DF4IAH/Smart-LCD/Docs/11_CPU_&_Temp/ATmega328P/ISP_Headers.png

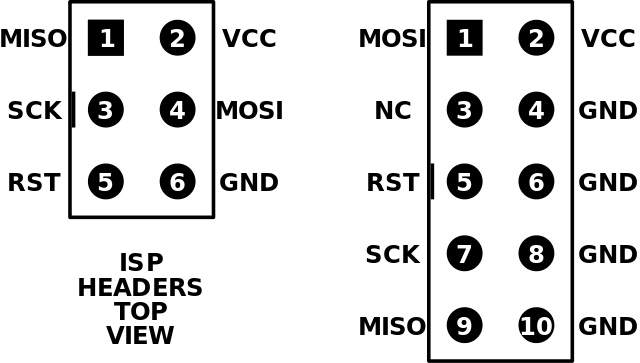
Docs/11_CPU_&_Temp/ATmega328P/ISP_Headers.png
