DF4IAH/Smart-LCD/Docs/61_Designing/Smart-LCD_1V1_BOM_6_calculations.xlsx

Stückliste exportiert aus Smart-LCD_1V1.sch am 30.05.17 14:22 |  |  |  |  |  | Nachbearbeitet von DF4IAH, 2017-05-30 | Preisgestaltung
Qty | Value | Device | Package | Parts | Description | Bemerkungen | Einzelpreis | Preis
1 | Smart-LCD V1.0 | Leiterplatte | 100 mm x 68 mm | PCB001 | PCB, Designed by DF4IAH | Smart-LCD V1.0 Leiterplatte | €6.90 | €6.90
1 | 27R | R-EU_R0805 | R0805 | R131 | RESISTOR, European symbol | Fotodioden-Eingang Schutzwiderstand. | €0.03 | €0.03
2 | 330R | R-EU_R0805 | R0805 | R151, R152 | RESISTOR, European symbol |  | €0.03 | €0.06
2 | 1kR | R-EU_R0805 | R0805 | R391, R392 | RESISTOR, European symbol | I2C-Bus open collector Sammelwiderstände. | €0.03 | €0.06
1 | 3.3kR | R-EU_R0805 | R0805 | R111 | RESISTOR, European symbol |  | €0.03 | €0.03
1 | 4.7kR | R-EU_R0805 | R0805 | R121 | RESISTOR, European symbol |  | €0.03 | €0.03
1 | 12kR | R-EU_R0805 | R0805 | R101 | RESISTOR, European symbol |  | €0.03 | €0.03
2 | 22kR | R-EU_R0805 | R0805 | R451, R454 | RESISTOR, European symbol |  | €0.03 | €0.06
1 | 100kR | R-EU_R0805 | R0805 | R221 | RESISTOR, European symbol |  | €0.03 | €0.03
1 | 650kR | R-EU_R0805 | R0805 | R222 | RESISTOR, European symbol |  | €0.03 | €0.03
1 | 1MR | R-EU_R0805 | R0805 | R132 | RESISTOR, European symbol | Fotodioden Arbeitspunkt. Noch experimental. | €0.05 | €0.05
1 | 10MR | R-EU_R0805 | R0805 | R211 | RESISTOR, European symbol | Ableitwiderstand für LCD-Modul bei Abschaltung. | €0.10 | €0.10
2 | 100pF | C-EUC0805 | C0805 | C103, C131 | CAPACITOR, European symbol |  | €0.20 | €0.40
1 | 470pF | C-EUC0805 | C0805 | C452 | CAPACITOR, European symbol |  | €0.20 | €0.20
6 | 100nF | C-EUC0805 | C0805 | C102, C111, C221, C301, C302, C402 | CAPACITOR, European symbol |  | €0.20 | €1.20
1 | 470nF | C-EUC0805 | C0805 | C455 | CAPACITOR, European symbol |  | €0.20 | €0.20
2 | 1uF | C-EUC0805 | C0805 | C211, C431 | CAPACITOR, European symbol |  | €0.20 | €0.40
2 | 4.7uF | C-EUC0805 | C0805 | C201, C202 | CAPACITOR, European symbol |  | €0.80 | €1.60
2 | 22uF | C-EUC0805 | C0805 | C101, C401 | CAPACITOR, European symbol |  | €1.25 | €2.50
2 | 47uF | C-EUC0805 | C0805 | C411, C412 | CAPACITOR, European symbol |  | €1.50 | €3.00
1 | BZX84-C2V4 | BAS70-04 | SOT23 | D131 | Silicon Schottky Diodes | Schutzdioden für Fotodioden-Eingang. Noch experimental. | €0.10 | €0.10
1 | MMBT2222AL | MMBT2222AL | SOT23 | Q121 | MMBT2222L, MMBT2222AL, SMMBT2222AL | NPN-Transistor für Backlight ein/aus (PWM). | €0.10 | €0.10
1 | MEGA8-P | MEGA8-P | DIL28-3 | U101 | MICROCONTROLLER | µC ATmega 328P. Kann zusätzlich gesockelt werden. | €2.20 | €2.20
1 | DIL28-3 | SOCKET | DIL28-3 | U101a | DIL socket | Präzissionsfassung, 28-polig, schmal (0,3 Zoll) | €1.80 | €1.80
1 | TS4871ID | TS4871ID | SO08 | U401 | STMICROELECTRONICS TS4871ID | Audioverstärker für einen Kanal. | €1.90 | €1.90
1 | LCD_23WAY__UC1608 | LCD_23WAY__UC1608 | 23X01_1MM27__UC1608 | X201 | Gfx-LCD UC1608 socket | 240x128 Pixel Gfx-Display wird direkt eingelötet. | €39.90 | €39.90
1 | Audio-Stiftleiste | HEADER-2X2 | 2X02 | X411 | Header 2X2 2.54mm | Anschluss für Lautsprecher mit Impedanz von >= 8 Ohm. | €0.60 | €0.60
1 | I2C-Stiftleiste | HEADER-2X3 | 2X03 | X301 | Header 2X3 2.54mm | Anschluss für I2C Stecker. | €0.80 | €0.80
1 | LDR-Stiftleiste | HEADER-1X2 | 1X02 | X131 | Header 1X2 2.54mm | Fotodioden-Anschluss. Noch experimental. | €0.60 | €0.60
1 | LEDs-Stiftleiste | HEADER-2X2 | 2X02 | X151 | Header 2X2 2.54mm | Anschluss für Duo-LEDs. | €0.60 | €0.60
1 | Switches-Stiftleiste | HEADER-2X2 | 2X02 | X141 | Header 2X2 2.54mm | Anschluss für Dreh-/Druckknopf mit I/Q Ausgang. | €0.60 | €0.60
 |  |  |  |  |  | SUMME |  | €66.11
