DF4IAH/Smart-LCD/CAD/Eagle/Smart-LCD_1V1.brd

## EAGLE design CAD/Eagle/Smart-LCD_1V1.brd (2017-06-25)

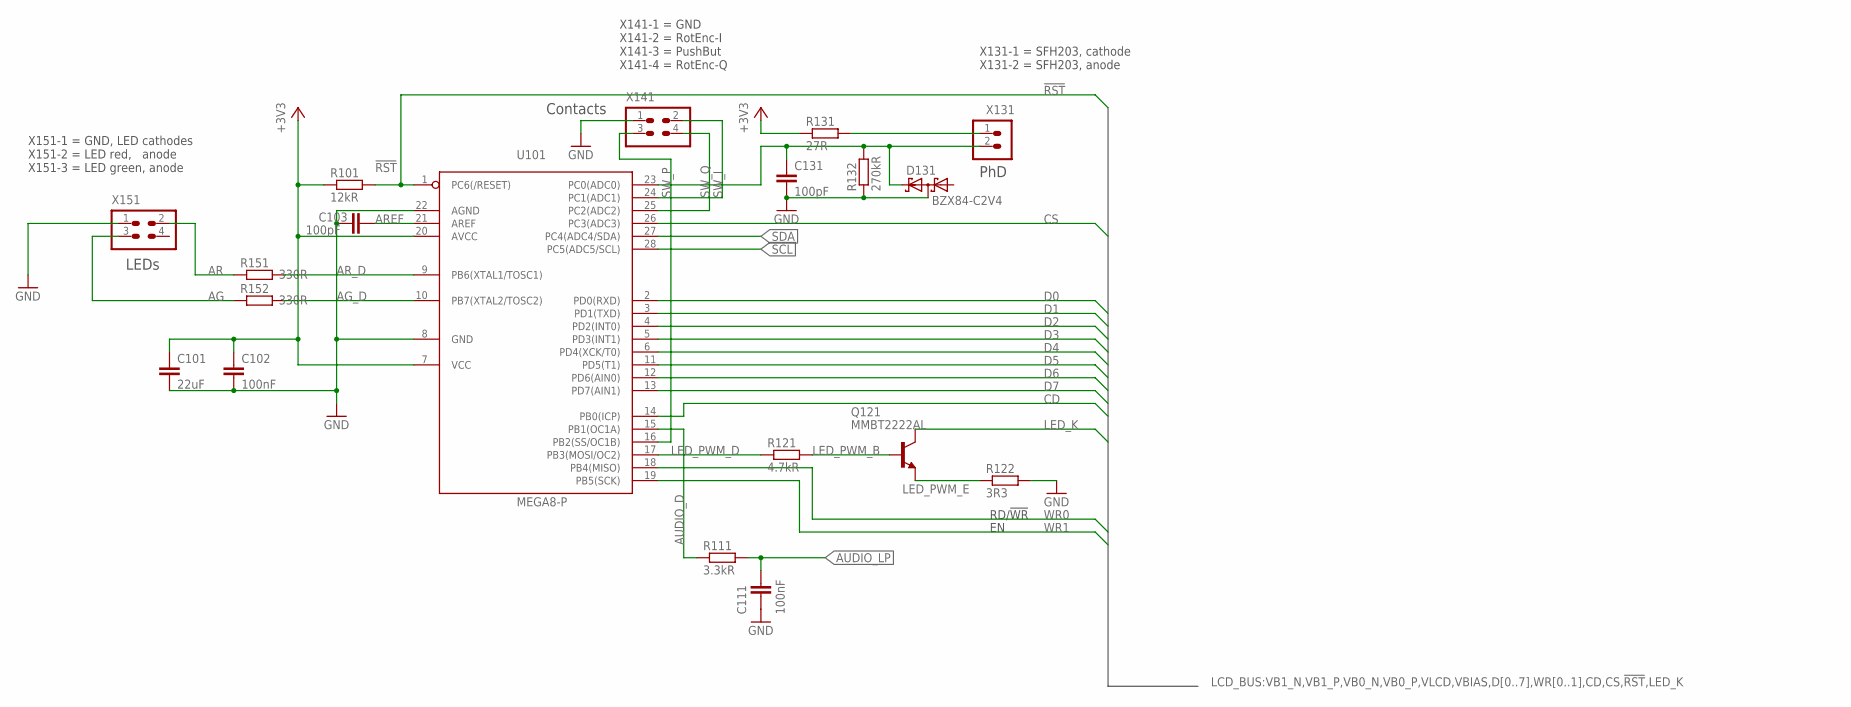
[picture p3: schematic Smart-LCD_1V1.sch, sheet 1, MPU]

Parts:
C101: 22uF; C0805
C102, C111: 100nF; C0805
C103, C131: 100pF; C0805
D131: BZX84-C2V4; SOT23
Q121: MMBT2222AL; SOT23
R101: 12kR; R0805
R111: 3.3kR; R0805
R121: 4.7kR; R0805
R122: 3R3; R0805
R131: 27R; R0805
R132: 270kR; R0805
R151, R152: 330R; R0805
U101: MEGA8-P; DIL28-3
X131: LDR; 1X02
X141: Switches; 2X02
X151: LEDs; 2X02

Connections:
!RST: R101.2, U101.1 (PC6(/RESET)); also elsewhere on the board
+3V3: C101.1, C102.1, R101.1, R131.1, U101.7 (VCC), U101.20 (AVCC); also elsewhere on the board
AG: R152.1, X151.3
AG_D: R152.2, U101.10 (PB7(XTAL2/TOSC2))
AR: R151.1, X151.2
AREF: C103.2, U101.21 (AREF)
AR_D: R151.2, U101.9 (PB6(XTAL1/TOSC1))
AUDIO_D: R111.1, U101.15 (PB1(OC1A))
AUDIO_LP: C111.1, R111.2; also elsewhere on the board
CD: U101.14 (PB0(ICP)); also elsewhere on the board
CS: U101.26 (PC3(ADC3)); also elsewhere on the board
D0: U101.2 (PD0(RXD)); also elsewhere on the board
D1: U101.3 (PD1(TXD)); also elsewhere on the board
D2: U101.4 (PD2(INT0)); also elsewhere on the board
D3: U101.5 (PD3(INT1)); also elsewhere on the board
D4: U101.6 (PD4(XCK/T0)); also elsewhere on the board
D5: U101.11 (PD5(T1)); also elsewhere on the board
D6: U101.12 (PD6(AIN0)); also elsewhere on the board
D7: U101.13 (PD7(AIN1)); also elsewhere on the board
GND: C101.2, C102.2, C103.1, C111.2, C131.2, D131.3 (C1A2), R122.2, R132.1, U101.8 (GND), U101.22 (AGND), X141.1, X151.1; also elsewhere on the board
LDR: C131.1, D131.2 (C2), R132.2, U101.23 (PC0(ADC0)), X131.2
LDR_P: R131.2, X131.1
LED_K: Q121.3 (C); also elsewhere on the board
LED_PWM_B: Q121.1 (B), R121.2
LED_PWM_D: R121.1, U101.17 (PB3(MOSI/OC2))
LED_PWM_E: Q121.2 (E), R122.1
SCL: U101.28 (PC5(ADC5/SCL)); also elsewhere on the board
SDA: U101.27 (PC4(ADC4/SDA)); also elsewhere on the board
SW_I: U101.24 (PC1(ADC1)), X141.2
SW_P: U101.16 (PB2(SS/OC1B)), X141.3
SW_Q: U101.25 (PC2(ADC2)), X141.4
WR0: U101.18 (PB4(MISO)); also elsewhere on the board
WR1: U101.19 (PB5(SCK)); also elsewhere on the board

Notes on the sheet:
PhD
Contacts
LEDs
RD/!WR
X131-1 = SFH203, cathode X131-2 = SFH203, anode
X151-1 = GND, LED cathodes X151-2 = LED red, anode X151-3 = LED green, anode
X141-1 = GND X141-2 = RotEnc-I X141-3 = PushBut X141-4 = RotEnc-Q

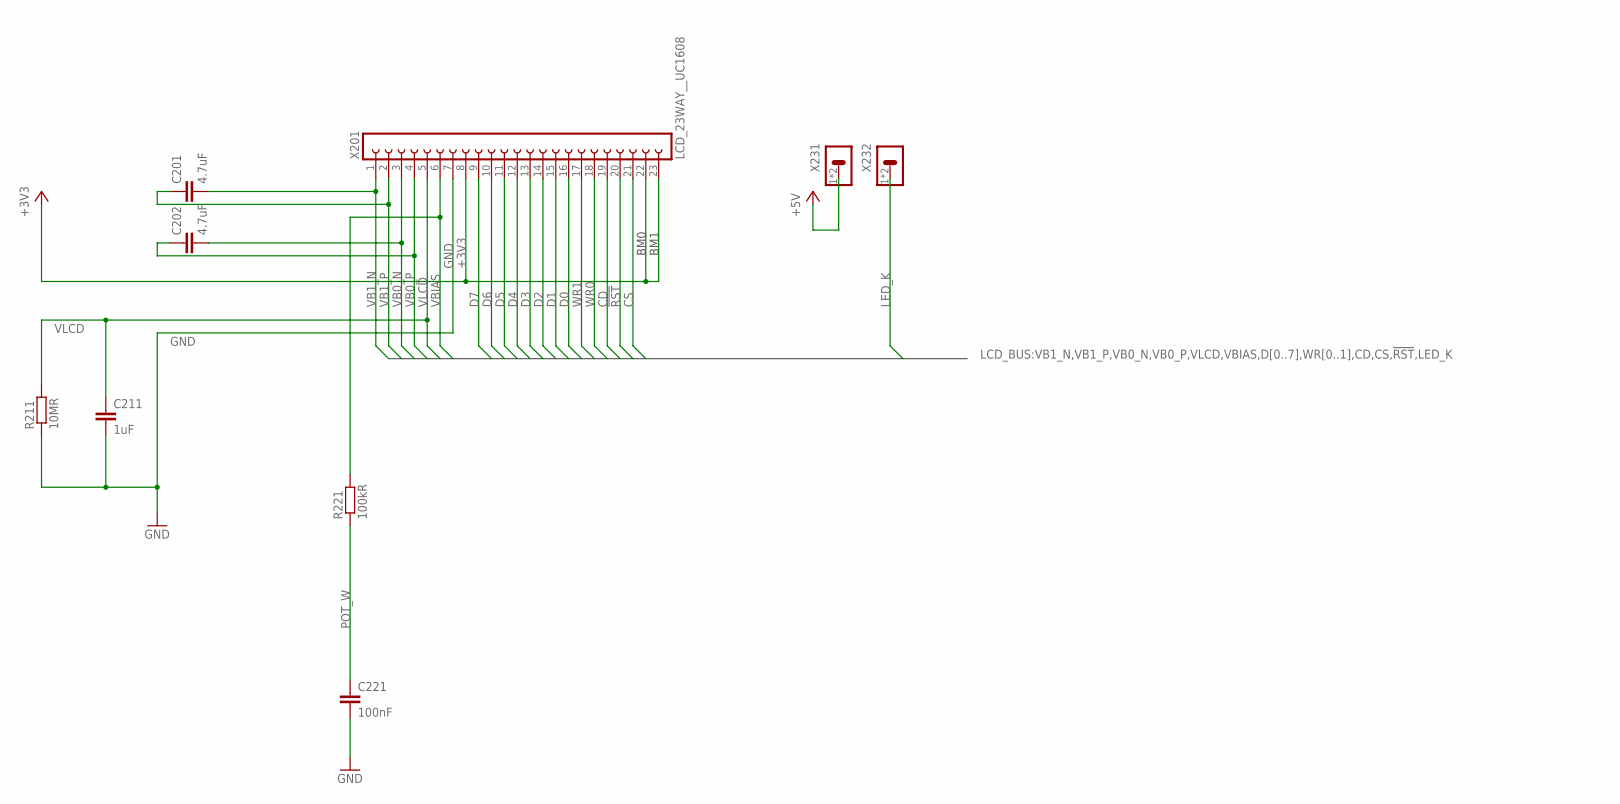
[picture p4: schematic Smart-LCD_1V1.sch, sheet 2, LCD panel]

Parts:
C201, C202: 4.7uF; C0805
C211: 1uF; C0805
C221: 100nF; C0805
R211: 10MR; R0805
R221: 100kR; R0805
X201: LCD_23WAY__UC1608; 23X01_1MM27__UC1608
X231: LED_A; P1-20X0.80
X232: LED_K; P1-20X0.80

Connections:
!RST: X201.20; also elsewhere on the board
+3V3: X201.8, X201.22, X201.23; also elsewhere on the board
+5V: X231.1, X231.2; also elsewhere on the board
CD: X201.19; also elsewhere on the board
CS: X201.21; also elsewhere on the board
D0: X201.16; also elsewhere on the board
D1: X201.15; also elsewhere on the board
D2: X201.14; also elsewhere on the board
D3: X201.13; also elsewhere on the board
D4: X201.12; also elsewhere on the board
D5: X201.11; also elsewhere on the board
D6: X201.10; also elsewhere on the board
D7: X201.9; also elsewhere on the board
GND: C211.2, C221.2, R211.1, X201.7; also elsewhere on the board
LED_K: X232.1, X232.2; also elsewhere on the board
POT_W: C221.1, R221.1
VB0_N: C202.2, X201.3
VB0_P: C202.1, X201.4
VB1_N: C201.2, X201.1
VB1_P: C201.1, X201.2
VBIAS: R221.2, X201.6
VLCD: C211.1, R211.2, X201.5
WR0: X201.18; also elsewhere on the board
WR1: X201.17; also elsewhere on the board

Notes on the sheet:
BM1
BM0

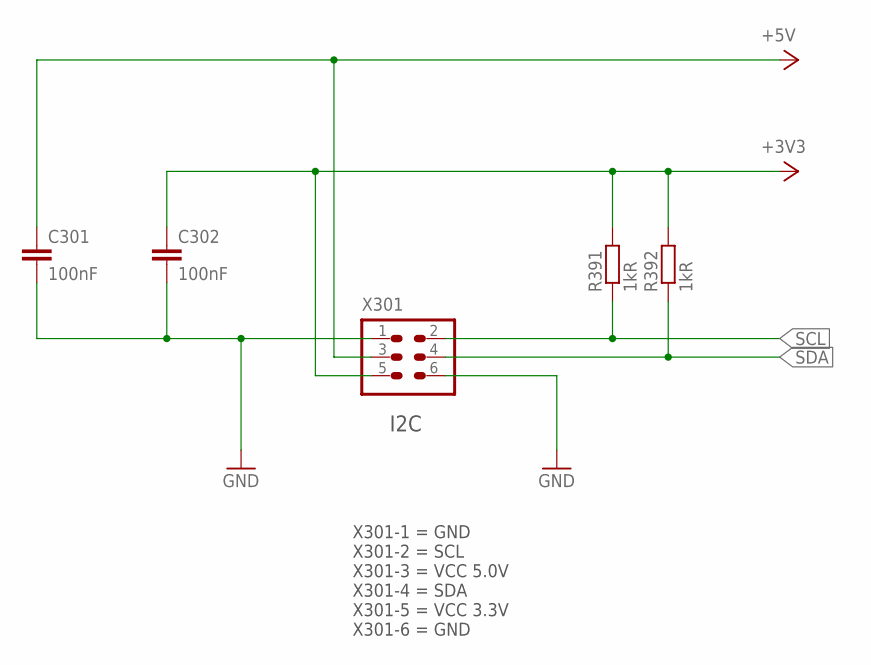
[picture p5: schematic Smart-LCD_1V1.sch, sheet 3, I2C connector]

Parts:
C301, C302: 100nF; C0805
R391, R392: 1kR; R0805
X301: I2C; 2X03

Connections:
+3V3: C302.1, R391.2, R392.2, X301.5; also elsewhere on the board
+5V: C301.1, X301.3; also elsewhere on the board
GND: C301.2, C302.2, X301.1, X301.6; also elsewhere on the board
SCL: R391.1, X301.2; also elsewhere on the board
SDA: R392.1, X301.4; also elsewhere on the board

Notes on the sheet:
I2C
X301-1 = GND X301-2 = SCL X301-3 = VCC 5.0V X301-4 = SDA X301-5 = VCC 3.3V X301-6 = GND

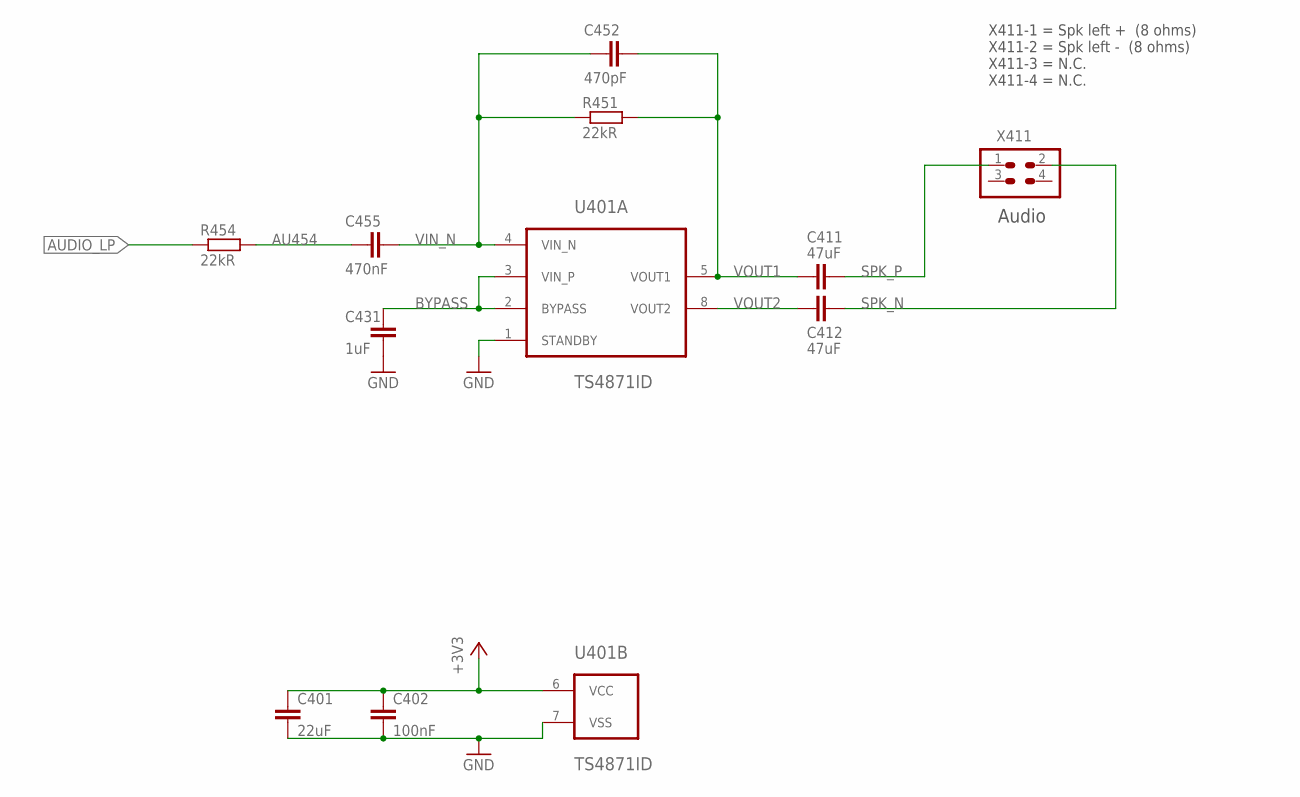
[picture p6: schematic Smart-LCD_1V1.sch, sheet 4, Audio]

Parts:
C401: 22uF; C0805
C402: 100nF; C0805
C411, C412: 47uF; C0805
C431: 1uF; C0805
C452: 470pF; C0805
C455: 470nF; C0805
R451, R454: 22kR; R0805
U401: TS4871ID; SO08
X411: Audio; 2X02

Connections:
+3V3: C401.1, C402.1, U401.6 (VCC); also elsewhere on the board
AU454: C455.1, R454.2
AUDIO_LP: R454.1; also elsewhere on the board
BYPASS: C431.1, U401.2 (BYPASS), U401.3 (VIN_P)
GND: C401.2, C402.2, C431.2, U401.1 (STANDBY), U401.7 (VSS); also elsewhere on the board
SPK_N: C412.2, X411.2
SPK_P: C411.2, X411.1
VIN_N: C452.1, C455.2, R451.1, U401.4 (VIN_N)
VOUT1: C411.1, C452.2, R451.2, U401.5 (VOUT1)
VOUT2: C412.1, U401.8 (VOUT2)

Notes on the sheet:
Audio
X411-1 = Spk left + (8 ohms) X411-2 = Spk left - (8 ohms) X411-3 = N.C. X411-4 = N.C.

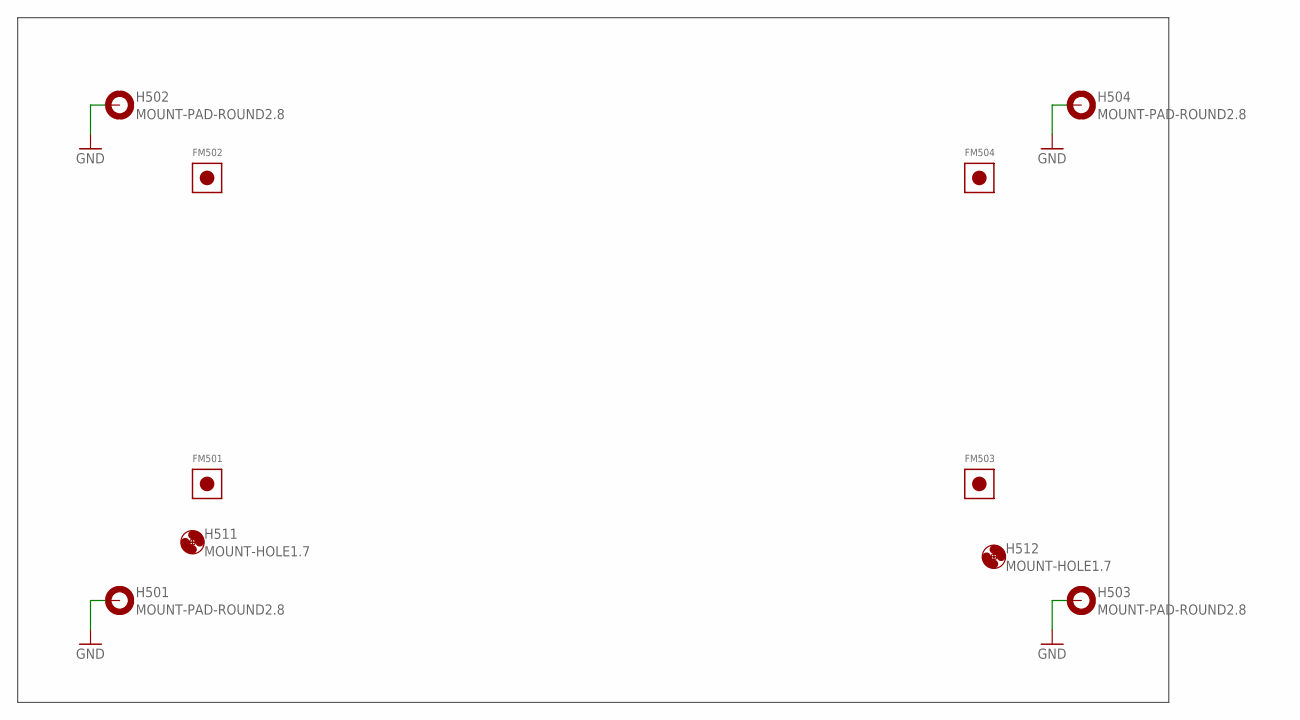
[picture p7: schematic Smart-LCD_1V1.sch, sheet 5, Holes]

Parts:
FM501, FM502, FM503, FM504: FIDUCIAL_MARK_1MM
H501, H502, H503, H504: MOUNT-PAD-ROUND2.8; 2,8-PAD
H511, H512: MOUNT-HOLE1.7; 1,7

Connections:
GND: H501.B2,8, H502.B2,8, H503.B2,8, H504.B2,8; also elsewhere on the board

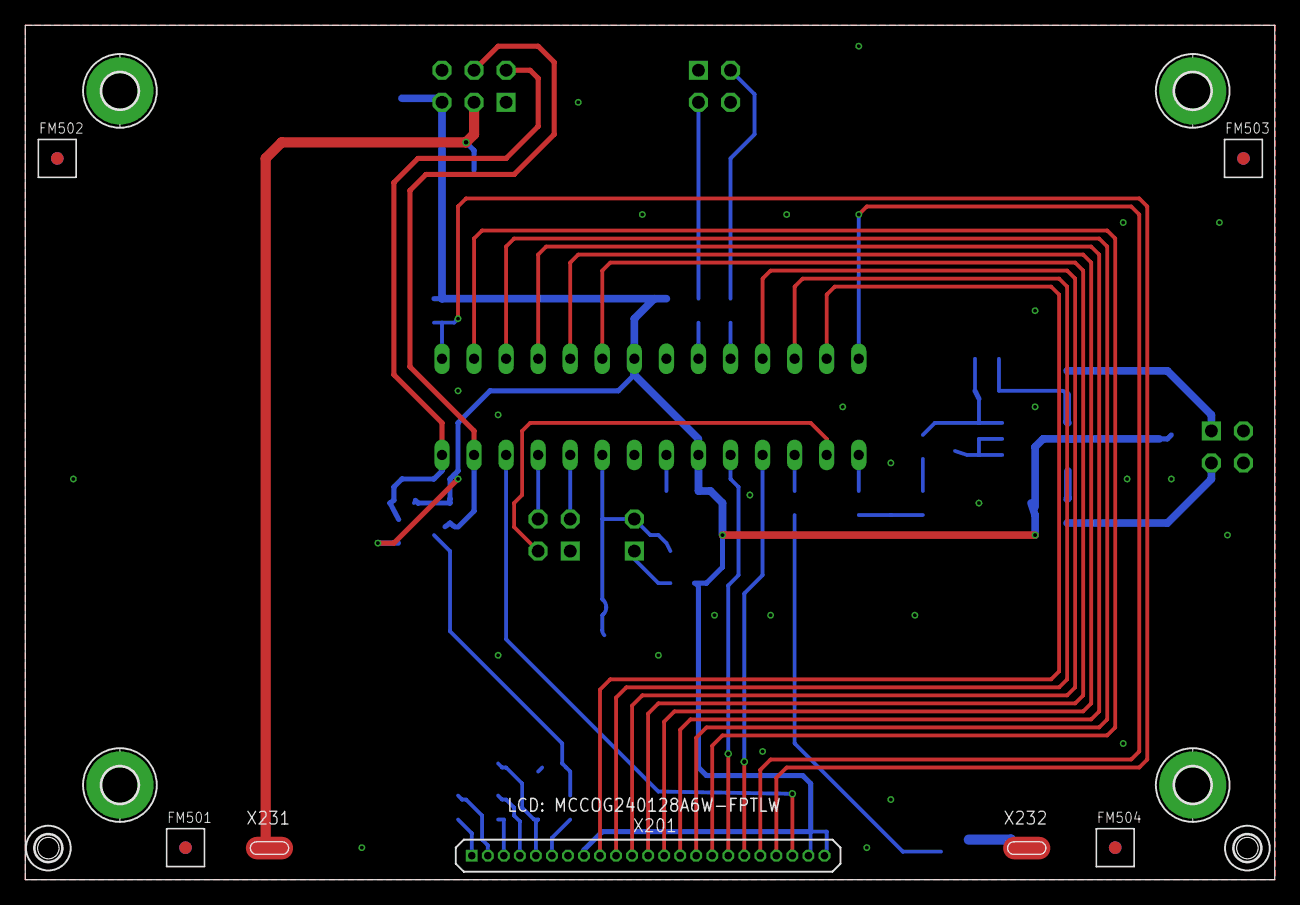
[picture p8: board Smart-LCD_1V1.brd from above]

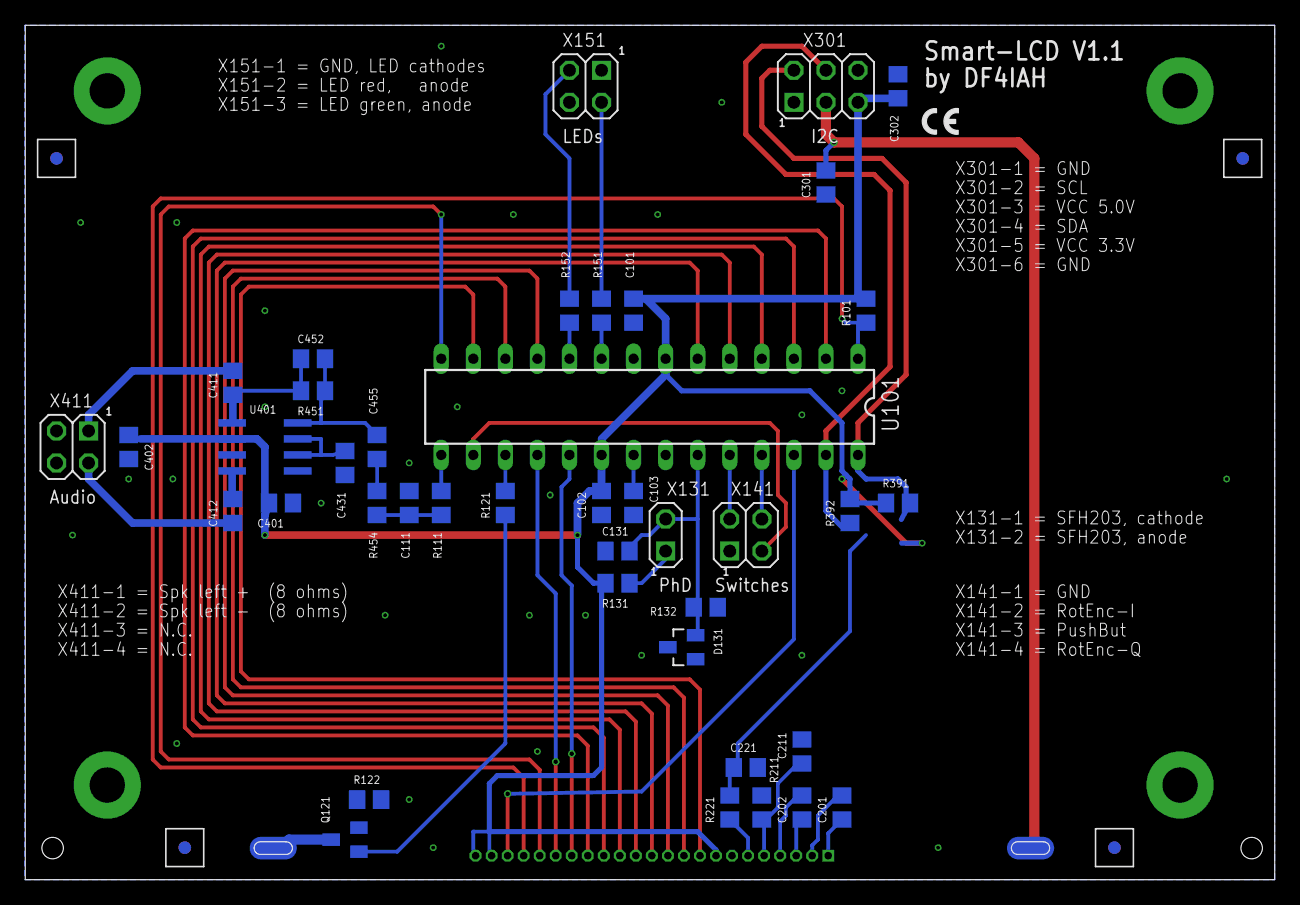
[picture p9: board Smart-LCD_1V1.brd from below]

Board: 2 copper layers, 99.0 x 67.7 mm, 54 parts (41 on the bottom side), 48 nets.
