DF4IAH/Smart-LCD/Smart-LCD_SW/Smart-LCD_SW/src/gfx_mono/gfx_mono_lcd_uc1608.c

/**
 * \file
 *
 * \brief Monochrome graphic library for the UC1608 LCD controller
 *
 * Copyright (c) 2011-2017 Atmel Corporation. All rights reserved.
 *
 * \asf_license_start
 *
 * \page License
 *
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
 * 3. The name of Atmel may not be used to endorse or promote products derived
 *    from this software without specific prior written permission.
 *
 * 4. This software may only be redistributed and used in connection with an
 *    Atmel microcontroller product.
 *
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
 * \asf_license_stop
 *
 */
/*
 * Support and FAQ: visit <a href="http://www.atmel.com/design-support/">Atmel Support</a>
 */
#include "lcd.h"

#include "gfx_mono_lcd_uc1608.h"


gfx_mono_lcd_uc1608_cache_data_t g_gfx_mono_lcd_uc1608_cache = { 0 };

/* forward-declarations */
static uint16_t gfx_mono_lcd_uc1608_cache_calc_adr(uint8_t page, uint8_t column);
static void gfx_mono_lcd_uc1608_cache_write_byte(uint8_t page, uint8_t column, uint8_t data);
static bool gfx_mono_lcd_uc1608_cache_read_byte(uint8_t page, uint8_t column, uint8_t* data);


/**
 * \ingroup gfx_mono_lcd_uc1608
 * @{
 */


/**
 * \brief Put a page from RAM to the LCD controller memory
 *
 * \param data Pointer to data to be written
 * \param page Page address
 * \param column Offset into page (x coordinate)
 * \param width Number of bytes to be written.
 */
void gfx_mono_lcd_uc1608_put_page(gfx_mono_color_t *data, gfx_coord_t page, gfx_coord_t page_offset, gfx_coord_t width)
{
	if (data &&
		(page					<  GFX_MONO_LCD_PAGES) &&
	    (page_offset			<  GFX_MONO_LCD_WIDTH)) {

		gfx_mono_color_t *data_pt = data;

		lcd_page_set(page);
		lcd_col_set(page_offset);

		if (page_offset + width > GFX_MONO_LCD_WIDTH) {
			width = GFX_MONO_LCD_WIDTH - page_offset;
		}

		for (uint8_t cnt = width; cnt; --cnt) {
			lcd_bus_write_ram(*(data_pt++));						// Write byte slice to LCD panel
		}
	}

	gfx_mono_lcd_uc1608_cache_clear();
}

/**
 * \brief Read a page from the LCD controller memory into the RAM
 *
 * \param data   Pointer where to store the read data
 * \param page   Page address
 * \param column Offset into page (x coordinate)
 * \param width  Number of bytes to be read.
 */
void gfx_mono_lcd_uc1608_get_page(gfx_mono_color_t *data, gfx_coord_t page, gfx_coord_t page_offset, gfx_coord_t width)
{
	if (data &&
	(page					<  GFX_MONO_LCD_PAGES) &&
	(page_offset			<  GFX_MONO_LCD_WIDTH)) {

		gfx_mono_color_t *data_pt = data;

		lcd_page_set(page);
		lcd_col_set(page_offset);

		if (page_offset + width > GFX_MONO_LCD_WIDTH) {
			width = GFX_MONO_LCD_WIDTH - page_offset;
		}

		for (uint8_t cnt = width; cnt; --cnt) {
			*(data_pt++) = lcd_bus_read_ram();						// Read byte slice from LCD panel
		}
	}
}

/**
 * \brief Draw pixel to LCD controller memory
 *
 * \param x         X coordinate of the pixel
 * \param y         Y coordinate of the pixel
 * \param color     Pixel operation.
 */
void gfx_mono_lcd_uc1608_draw_pixel(gfx_coord_t x, gfx_coord_t y, gfx_mono_color_t color)
{
	if ((x < GFX_MONO_LCD_WIDTH) && (y < GFX_MONO_LCD_HEIGHT)) {
		gfx_coord_t			page		= y / GFX_MONO_LCD_PIXELS_PER_BYTE;
		gfx_mono_color_t	pixel_mask	= 1 << (y % GFX_MONO_LCD_PIXELS_PER_BYTE);

		gfx_mono_lcd_uc1608_mask_byte(page, x, pixel_mask, color);
	}
}

/**
 * \brief Get the pixel value at x,y in the LCD controller memory
 *
 * \param x      X coordinate of pixel
 * \param y      Y coordinate of pixel
 * \return Non zero value if pixel is set.
 */
uint8_t gfx_mono_lcd_uc1608_get_pixel(gfx_coord_t x, gfx_coord_t y)
{
	uint8_t isSet = GFX_PIXEL_CLR;

	if ((x < GFX_MONO_LCD_WIDTH) && (y < GFX_MONO_LCD_HEIGHT)) {
		gfx_coord_t			page		= y / GFX_MONO_LCD_PIXELS_PER_BYTE;
		gfx_mono_color_t	pixel_mask	= 1 << (y % GFX_MONO_LCD_PIXELS_PER_BYTE);
		uint8_t				byte = gfx_mono_lcd_uc1608_get_byte(page, x);

		isSet = (byte & pixel_mask) ?  GFX_PIXEL_SET : GFX_PIXEL_CLR;
	}
	return isSet;
}

/**
 * \brief Put a byte to the LCD controller memory
 *
 * \param page   Page address
 * \param column Page offset (x coordinate)
 * \param data   Data to be written.
 */
void gfx_mono_lcd_uc1608_put_byte(gfx_coord_t page, gfx_coord_t column, uint8_t data)
{
	if ((page < GFX_MONO_LCD_PAGES) && (column < GFX_MONO_LCD_WIDTH)) {
		/* Write back modified (dirty) data to the cache */
		gfx_mono_lcd_uc1608_cache_write_byte(page, column, data);

		/* Write current data back to the display device */
		lcd_page_set(page);
		lcd_col_set(column);
		lcd_bus_write_ram(data);									// Write byte slice to RAM
	}
}

/**
 * \brief Get a byte from the LCD controller memory
 *
 * \param page   Page address
 * \param column Page offset (x coordinate)
 * \return       data from LCD controller.
 */
uint8_t gfx_mono_lcd_uc1608_get_byte(gfx_coord_t page, gfx_coord_t column)
{
	uint8_t data = 0;

	if ((page < GFX_MONO_LCD_PAGES) && (column < GFX_MONO_LCD_WIDTH)) {
		/* Request data from the cache */
		if (gfx_mono_lcd_uc1608_cache_read_byte(page, column, &data)) {
			return data;
		}

		/* Cache miss: read current data from the display unit */
		lcd_page_set(page);
		lcd_col_set(column);
		data = lcd_bus_read_ram();									// Read byte slice from RAM

		/* Store current data to the cache */
		gfx_mono_lcd_uc1608_cache_write_byte(page, column, data);
	}

	return data;
}

/**
 * \brief Read/Modify/Write a byte in the LCD controller memory
 *
 * This function will read the byte from the LCD controller and
 * do a mask operation on the byte according to the pixel operation selected
 * by the color argument and the pixel mask provided.
 *
 * \param page       Page address
 * \param column     Page offset (x coordinate)
 * \param pixel_mask Mask for pixel operation
 * \param color      Pixel operation
 */
void gfx_mono_lcd_uc1608_mask_byte(gfx_coord_t page, gfx_coord_t column, gfx_mono_color_t pixel_mask, gfx_mono_color_t color)
{
	uint8_t data = 0;

	if ((page < GFX_MONO_LCD_PAGES) && (column < GFX_MONO_LCD_WIDTH)) {
		data = gfx_mono_lcd_uc1608_get_byte(page, column);

		switch (color) {
			case GFX_PIXEL_CLR:
				data &= ~pixel_mask;
				break;

			case GFX_PIXEL_SET:
				data |= pixel_mask;
				break;

			case GFX_PIXEL_XOR:
				data ^= pixel_mask;
				break;
		}

		gfx_mono_lcd_uc1608_put_byte(page, column, data);
	}
}


/**
 * \brief Search an index position of a cached address
 *
 * This function does a look-up and searches for the index of
 * the cache-array, where the byte position matches.
 *
 * \param page       Page address
 * \param column     Page offset (x coordinate)
 * \return           Address value to be used for the caching-system.
 */
static uint16_t gfx_mono_lcd_uc1608_cache_calc_adr(uint8_t page, uint8_t column)
{
	if ((page < GFX_MONO_LCD_PAGES) && (column < GFX_MONO_LCD_WIDTH)) {
		return 0x4000U | (((uint16_t) page) << 8) | column;
	}
	return 0x8000U;  // Non-valid position
}

/**
 * \brief Clear all cached data
 *
 */
inline
void gfx_mono_lcd_uc1608_cache_clear()
{
	g_gfx_mono_lcd_uc1608_cache.adr = 0;
}

/**
 * \brief Store changed data to the cache
 *
 * This function stores the data to the cache. The importance is re-calculated for each
 * cache items.
 *
 * \param page       Page address
 * \param column     Page offset (x coordinate)
 * \param data       Data to be stored in the cache
 */
static void gfx_mono_lcd_uc1608_cache_write_byte(uint8_t page, uint8_t column, uint8_t data)
{
	const uint16_t adr = gfx_mono_lcd_uc1608_cache_calc_adr(page, column);
	if (!(adr & 0x4000U)) {
		return;														// Non-valid position
	}

	g_gfx_mono_lcd_uc1608_cache.adr  = adr;
	g_gfx_mono_lcd_uc1608_cache.data = data;
}

/**
 * \brief Search an index position of a cached address
 *
 * This function does a look-up and searches for the index of
 * the cache-array, where the byte position matches.
 *
 * \param page       Page address
 * \param column     Page offset (x coordinate)
 * \param data		 Address to which data should be stored at
 * \return           True if data returned, false when cache miss has happened.
 */
static bool gfx_mono_lcd_uc1608_cache_read_byte(uint8_t page, uint8_t column, uint8_t* data)
{
	const uint16_t adr = gfx_mono_lcd_uc1608_cache_calc_adr(page, column);

	if ((adr & 0x4000) && (g_gfx_mono_lcd_uc1608_cache.adr == adr) && data) {
		*data = g_gfx_mono_lcd_uc1608_cache.data;
		return true;
	}
	return false;  // No cache data stored into target
}


/** @} */
