DF4IAH/Smart-LCD/Smart-LCD_SW/Smart-LCD_SW/src/config/conf_sysfont.h

/**
 * \file
 *
 * \brief Default configurations for sysfont
 *
 * Copyright (c) 2014-2015 Atmel Corporation. All rights reserved.
 *
 * \asf_license_start
 *
 * \page License
 *
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
 * 3. The name of Atmel may not be used to endorse or promote products derived
 *    from this software without specific prior written permission.
 *
 * 4. This software may only be redistributed and used in connection with an
 *    Atmel microcontroller product.
 *
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
 * \asf_license_stop
 *
 */
/*
 * Support and FAQ: visit <a href="http://www.atmel.com/design-support/">Atmel Support</a>
 */
#ifndef CONF_SYSFONT_H
#define CONF_SYSFONT_H

/**
 * \weakgroup gfx_mono_sysfont
 * @{
 */

#include <stdint.h>

/* #define USE_FONT_BPMONO_10x16 */
/* #define USE_FONT_BPMONO_10x14 */
/* #define USE_FONT_MONO_MMM_10x12 */
#define USE_FONT_BASIC_6x7

#if defined(USE_FONT_BPMONO_10x16)
/** Width of each glyph, including spacer column. */
#  define SYSFONT_WIDTH           10
/** Height of each glyph, excluding spacer line. */
#  define SYSFONT_HEIGHT          16
/** Line height. */
#  define SYSFONT_LINESPACING     8
/** First character defined. */
#  define SYSFONT_FIRSTCHAR       ((uint8_t)' ')
/** Last character defined. */
#  define SYSFONT_LASTCHAR        ((uint8_t)'}')

/** Define variable containing the font */
#  define SYSFONT_DEFINE_GLYPHS \
        /* Glyph data, row by row, MSB is leftmost pixel, one byte per row. */ \
	static PROGMEM_DECLARE(uint8_t, sysfont_glyphs[]) = { \
		/* "BPmono" font (http://www.backpacker.gr) at size 10x16 */ \
		0x00, 0x00, 0x00, 0x00, 0x00, 0x00, 0x00, 0x00, 0x00, 0x00, \
		0x00, 0x00, 0x00, 0x00, 0x00, 0x00, 0x00, 0x00, 0x00, 0x00, \
		0x00, 0x00, 0x00, 0x00, 0x00, 0x00, 0x00, 0x00, 0x00, 0x00, \
		0x00, 0x00, /*   */ \
		0x00, 0x00, 0x00, 0x00, 0x00, 0x00, 0x30, 0x00, 0x30, 0x00, \
		0x30, 0x00, 0x30, 0x00, 0x30, 0x00, 0x30, 0x00, 0x30, 0x00, \
		0x00, 0x00, 0x30, 0x00, 0x30, 0x00, 0x00, 0x00, 0x00, 0x00, \
		0x00, 0x00, /* ! */ \
		0x00, 0x00, 0x00, 0x00, 0x00, 0x00, 0x6C, 0x00, 0x6C, 0x00, \
		0x6C, 0x00, 0x6C, 0x00, 0x00, 0x00, 0x00, 0x00, 0x00, 0x00, \
		0x00, 0x00, 0x00, 0x00, 0x00, 0x00, 0x00, 0x00, 0x00, 0x00, \
		0x00, 0x00, /* " */ \
		0x00, 0x00, 0x00, 0x00, 0x00, 0x00, 0x00, 0x00, 0x48, 0x00, \
		0x48, 0x00, 0xFC, 0x00, 0x48, 0x00, 0x48, 0x00, 0x48, 0x00, \
		0xFC, 0x00, 0x48, 0x00, 0x48, 0x00, 0x00, 0x00, 0x00, 0x00, \
		0x00, 0x00, /* # */ \
		0x00, 0x00, 0x00, 0x00, 0x00, 0x00, 0x10, 0x00, 0x10, 0x00, \
		0x3C, 0x00, 0x40, 0x00, 0x30, 0x00, 0x08, 0x00, 0x04, 0x00, \
		0x78, 0x00, 0x10, 0x00, 0x10, 0x00, 0x00, 0x00, 0x00, 0x00, \
		0x00, 0x00, /* $ */ \
		0x00, 0x00, 0x00, 0x00, 0x00, 0x00, 0x00, 0x00, 0x7C, 0x00, \
		0xA4, 0x00, 0xA8, 0x00, 0x48, 0x00, 0x10, 0x00, 0x14, 0x00, \
		0x2A, 0x00, 0x4A, 0x00, 0x44, 0x00, 0x00, 0x00, 0x00, 0x00, \
		0x00, 0x00, /* % */ \
		0x00, 0x00, 0x00, 0x00, 0x00, 0x00, 0x70, 0x00, 0x88, 0x00, \
		0x88, 0x00, 0x88, 0x00, 0x70, 0x00, 0x88, 0x00, 0x8A, 0x00, \
		0x8A, 0x00, 0x8C, 0x00, 0x70, 0x00, 0x00, 0x00, 0x00, 0x00, \
		0x00, 0x00, /* & */ \
		0x00, 0x00, 0x00, 0x00, 0x00, 0x00, 0x10, 0x00, 0x10, 0x00, \
		0x10, 0x00, 0x00, 0x00, 0x00, 0x00, 0x00, 0x00, 0x00, 0x00, \
		0x00, 0x00, 0x00, 0x00, 0x00, 0x00, 0x00, 0x00, 0x00, 0x00, \
		0x00, 0x00, /* ' */ \
		0x00, 0x00, 0x00, 0x00, 0x08, 0x00, 0x10, 0x00, 0x10, 0x00, \
		0x20, 0x00, 0x20, 0x00, 0x20, 0x00, 0x20, 0x00, 0x20, 0x00, \
		0x20, 0x00, 0x10, 0x00, 0x10, 0x00, 0x08, 0x00, 0x00, 0x00, \
		0x00, 0x00, /* ( */ \
		0x00, 0x00, 0x00, 0x00, 0x20, 0x00, 0x10, 0x00, 0x10, 0x00, \
		0x08, 0x00, 0x08, 0x00, 0x08, 0x00, 0x08, 0x00, 0x08, 0x00, \
		0x08, 0x00, 0x10, 0x00, 0x10, 0x00, 0x20, 0x00, 0x00, 0x00, \
		0x00, 0x00, /* ) */ \
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
	};
#elif defined(USE_FONT_BPMONO_10x14)
/** Width of each glyph, including spacer column. */
#  define SYSFONT_WIDTH           10
/** Height of each glyph, excluding spacer line. */
#  define SYSFONT_HEIGHT          14
/** Line height. */
#  define SYSFONT_LINESPACING     8
/** First character defined. */
#  define SYSFONT_FIRSTCHAR       ((uint8_t)' ')
/** Last character defined. */
#  define SYSFONT_LASTCHAR        ((uint8_t)'}')

/** Define variable containing the font */
#  define SYSFONT_DEFINE_GLYPHS \
        /* Glyph data, row by row, MSB is leftmost pixel, one byte per row. */ \
	static PROGMEM_DECLARE(uint8_t, sysfont_glyphs[]) = { \
		/* "BPmono" font (http://www.backpacker.gr) at size 10x14 */ \
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
		0xf8, 0x80, 0x80, 0xe0, 0x80, 0x80, 0x80,          /* "F" */ \
		0x70, 0x88, 0x80, 0x80, 0x98, 0x88, 0x70,          /* "G" */ \
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
		0x20, 0x50, 0x20, 0x00, 0x00, 0x00, 0x00,          /* "°" = 167d mapped @ 0x7e */ \
	};
#endif

/** @} */

#endif /* CONF_SYSFONT_H */
