DF4IAH/Smart-LCD/Smart-LCD_SW/Smart-LCD_SW/src/config/conf_board.h

/**
 * \file
 *
 * \brief User board configuration template
 *
 */
/*
 * Support and FAQ: visit <a href="http://www.atmel.com/design-support/">Atmel Support</a>
 */

#ifndef CONF_BOARD_H
#define CONF_BOARD_H

// no special variants to decide from

#endif // CONF_BOARD_H
