DF4IAH/Smart-LCD/(commit log)

2017-01-24 CAD, Docs - initial set-up
2017-02-03 CAD/Docs - initial set-up for new design
    [Smart-LCD_1V0.brd, Smart-LCD_1V0.sch]
2017-02-04 CAD - first layout worked on
    [Smart-LCD_1V0.brd, Smart-LCD_1V0.sch]
2017-02-05 CAD - routed, but audio amplifier still TODO
    [Smart-LCD_1V0.brd, Smart-LCD_1V0.sch]
2017-02-06 CAD - audio amplifier added, but CPU must be placed on the solder side
    [Smart-LCD_1V0.brd, Smart-LCD_1V0.sch]
2017-02-06 CAD - CPU placed on the solder side
    [Smart-LCD_1V0.brd]
2017-02-07 CAD - minor corrections and PCB V1.0 ordering done
    [Smart-LCD_1V0.brd, Smart-LCD_1V0.sch]
2017-02-08 SW - all needed ASF services and drivers added
2017-02-08 SW - I/O wires connected
2017-02-11 SW - ADC init done, ISR: ADC done
2017-02-26 SW - display attached to new arrived PCB, some changes done at the LCD communication section
2017-02-26 SW - most of the display works, still searching for timer bug
    [gfx_mono_generic.c, gfx_mono_lcd_uc1608.c, init.c, isr.c, isr.h, lcd.c, lcd.h, main.c]
2017-02-27 SW - timers are running, ADC ISR only one time called
2017-02-27 SW - ADC temperature working
2017-02-27 SW - test code for PWM channels of audio out and LCD backlight added
2017-02-27 CAD - changed value - C111 22nF --> 100 nF
    [Smart-LCD_1V0.brd, Smart-LCD_1V0.sch]
2017-02-28 CAD - new version V1.1 - missing resistor for LDR added, missing header pin number 1 marking added
    [Smart-LCD_1V1.brd, Smart-LCD_1V1.sch]
2017-02-28 CAD - four fiducials added
    [Smart-LCD_1V1.brd, Smart-LCD_1V1.sch]
2017-03-04 SW - TWI interface - some debugging around STOP/START that triggers a problem in the TWI state-machine
    [isr.c, main.c, twi.c, twi.h]
2017-03-04 SW - sleep mode enabled - TWI: no more debugging with 10MHz-Ref-Osc possible due to error there
    [main.c]
2017-03-04 CAD - I2C pull-ups changed to 1kR
    [Smart-LCD_1V0.brd, Smart-LCD_1V0.sch]
2017-03-05 CAD - wire sizes of less than 0.3048 changed to 0.3048mm
    [Smart-LCD_1V1.brd]
2017-03-05 CAD - branching works
2017-03-05 SW - branching works
    [Smart-LCD_1V0.brd, Smart-LCD_1V0.sch]
2017-03-05 Docs - new branch added
    [Smart-LCD_1V1.brd, Smart-LCD_1V1.sch]
2017-03-05 master - branching works
    [Smart-LCD_1V1.brd, Smart-LCD_1V1.sch]
2017-03-26 HW_V1.1 - LCD backlight basis resistor chnaged to 4.7k ohms
    [Smart-LCD_1V1.brd, Smart-LCD_1V1.sch]
2017-03-29 SW - I2C version request answered
2017-03-30 SW - first I2C version command OK, second one implemented
2017-03-31 SW - renaming from LDR to PD (photo diode) of the V1.1 design
2017-03-31 SW - missing show_clk_state added
    [lcd.c, lcd.h, twi.c]
2017-04-02 SW - displaying all 10MHz-Ref.-Osc. parameters at I2C address 0x22
2017-04-02 SW - more TWI fixes done
    [lcd.c, lcd.h, twi.c, twi.h]
2017-04-02 SW - TWI data of latitude/longitude reworked
    [lcd.c]
2017-04-03 SW - some more TWI issues fixed
    [lcd.c, lcd.h, main.c, twi.c, twi.h]
2017-04-07 SW - some more graphic issues
    [lcd.c, lcd.h, main.c, main.h]
2017-04-08 SW - TWI - ISR functions are constantly in disabled interrupt context
2017-04-08 SW - display PWM value, fractional part fixed
    [lcd.c, lcd.h, main.h]
2017-04-08 HW_V1.1 - photo diode - resistor change from 100k to 1MR
    [Smart-LCD_1V1.brd, Smart-LCD_1V1.sch]
2017-04-08 SW - Duo-LED and audio interface activated
2017-04-10 SW - interrupt optimizations
2017-04-15 SW - PWM value presentation fixed
    [lcd.c]
2017-04-15 SW - phase offset sound pitch deviation reversed
    [isr.c]
2017-04-16 SW - message length of meters.decimeters fixed
    [twi.c]
2017-05-14 SW - PhaseOfs *4 for audio pitch calculation
2017-05-30 HW_V1.1 - BOM added
2017-05-30 HW_V1.1 - BOM removed again
2017-05-30 DOCS - BOM added
    [Smart-LCD_1V1_BOM_5_kalkuliert.xlsx]
2017-05-30 HW_V1.0 - screenshots of schematic and board added
2017-05-30 HW_V1.1 - I2C poti removed
    [Smart-LCD_1V1.brd, Smart-LCD_1V1.sch]
2017-05-30 DOCS - BOM added (2)
    [Smart-LCD_1V1_BOM_6_calculations.xlsx]
2017-05-30 SW - info about fuse settings added
2017-05-31 SW - LCD contrast voltage setting by Switch-I/-Q input for increase and decrease of voltage. Push button for writing setting into the EEPROM.
2017-06-17 SW - some data index positions fixed
    [lcd.c, twi.c, twi.h]
2017-06-20 HW_V1.1 - suggestions of Hans, DK1NB added
    [Smart-LCD_1V1.brd, Smart-LCD_1V1.sch]
2017-06-20 SW - plotting text issue done
    [lcd.c, lcd.h, main.h, twi.c, twi.h]
2017-06-22 SW - automatic mode selection added for old 10 MHz-Ref-Osc firmware not switching mode itself
2017-06-25 HW_V1.1 - LCD backlight - 1 ohms added to the NPN's emitter
    [Smart-LCD_1V1.brd, Smart-LCD_1V1.sch]
2017-06-25 HW_V1.1 - df4iah_connector.lbr combined for Smart-LCD and FindMeSAT (2)
    [Smart-LCD_1V1.brd, Smart-LCD_1V1.sch]
2017-06-25 SW - much code replacement with ISR related functions
    [isr.c, isr.h, lcd.c, lcd.h, main.c, main.h, twi.c]
2017-06-28 SW - display area organized for demo mode, rotary switch decoder implemented
2017-07-25 SW - TWI - new commands for backlight, LEDs, rotary encoder and more - untested code
2017-07-27 SW - TWI - contrast settings fixed
    [gfx_mono_lcd_uc1608.h, lcd.h, main.c, main.h, twi.c, twi.h]
2017-08-05 SW - TWI - reset command added, cls command has new address
    [lcd.c, lcd.h, main.h, twi.c, twi.h]
2017-09-18 SW - Sound changed from PWM to digital output - removes 16 kHz tone
2018-03-14 HW_V1.0 - do not place I2C poti
    [Smart-LCD_1V0.brd, Smart-LCD_1V0.sch]
